Mitch-json/Smart-Toilet/Board Drawings/Right View.png

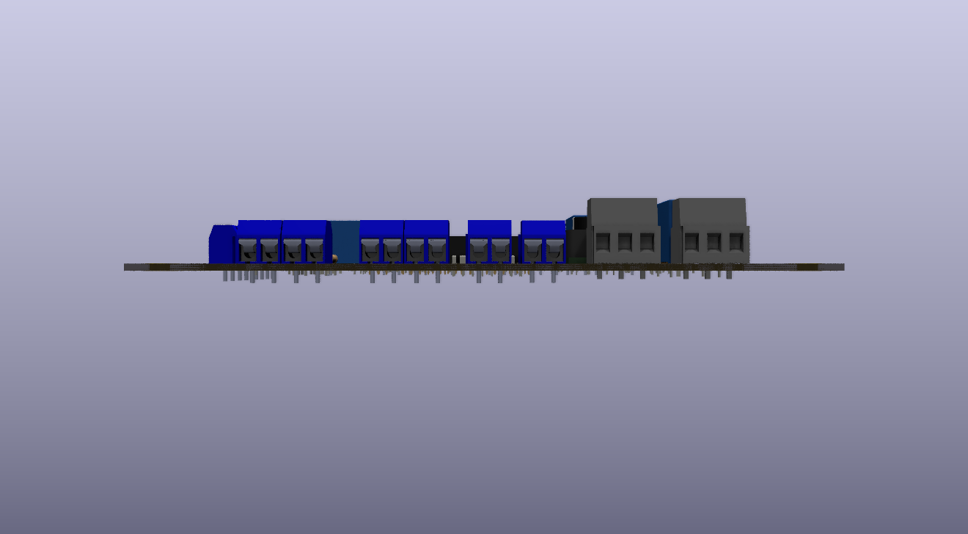
Board Drawings/Right View.png
