Mitch-json/Smart-Toilet/Board Drawings/Top View Animated.png

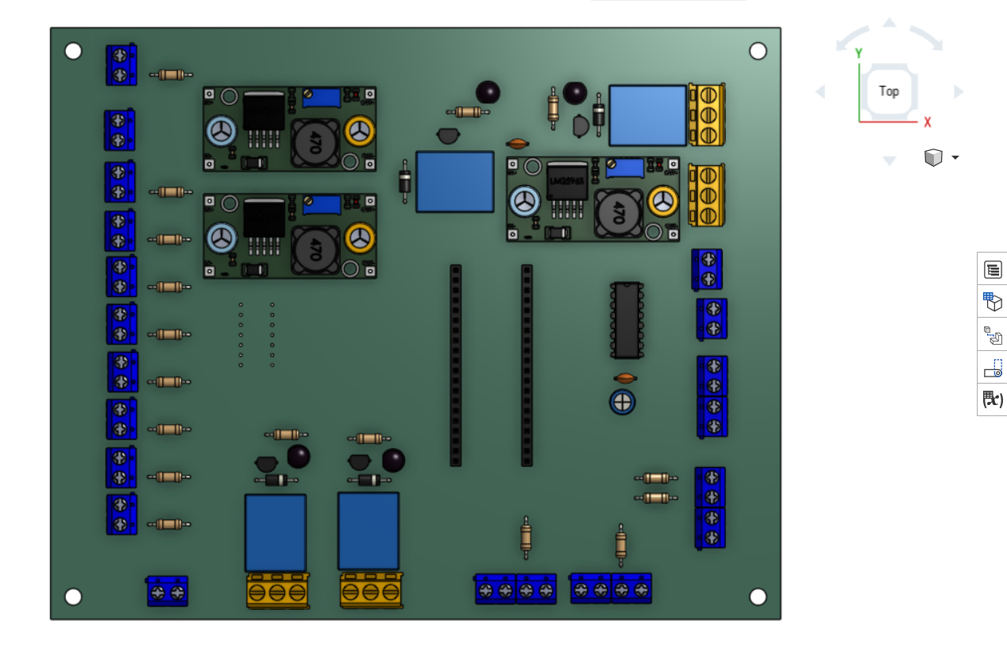
Board Drawings/Top View Animated.png
