Mitch-json/Smart-Toilet/3D Mechanical Designs/Motor Holder Dimensions.png

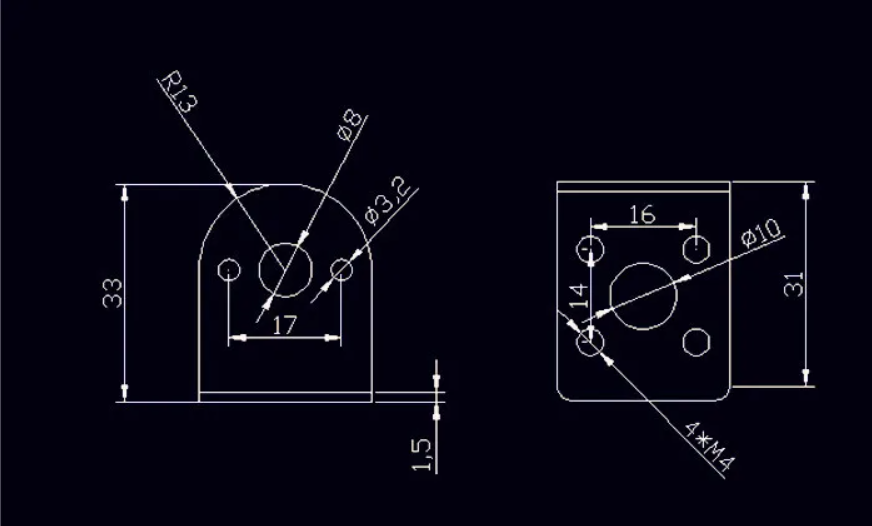
3D Mechanical Designs/Motor Holder Dimensions.png
