Mitch-json/Smart-Toilet/Board Drawings/Back View Animated.png

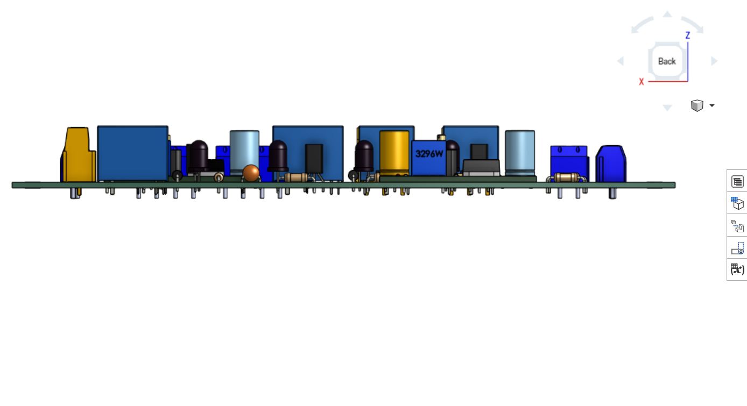
Board Drawings/Back View Animated.png
