Mitch-json/Smart-Toilet/Board Drawings/Back View Drawing.png

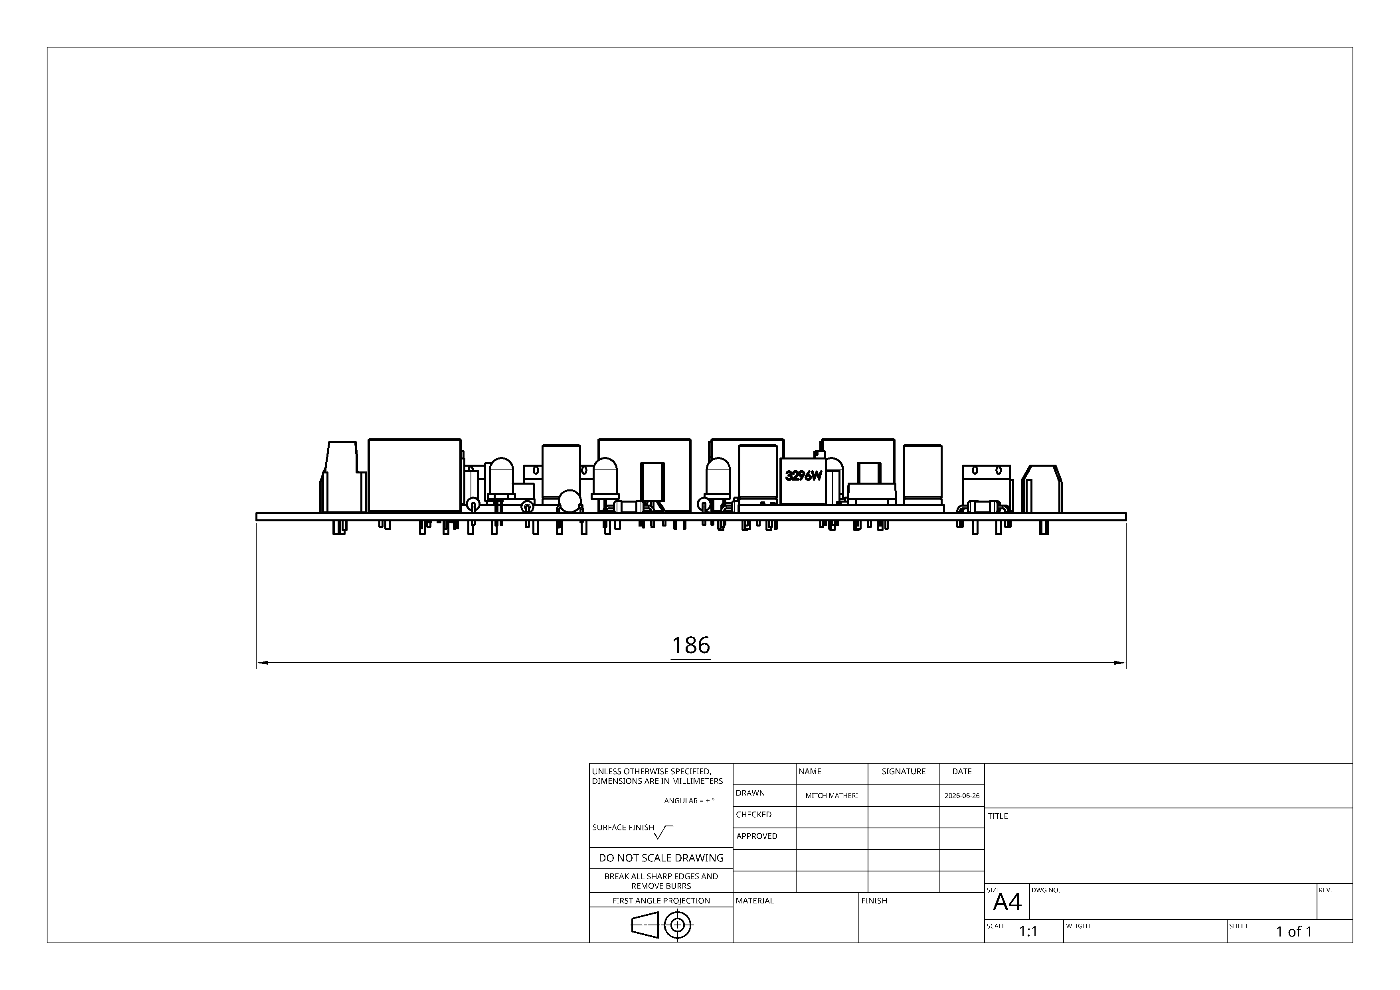
Board Drawings/Back View Drawing.png
