Mitch-json/Smart-Toilet/Board Drawings/Back View.png

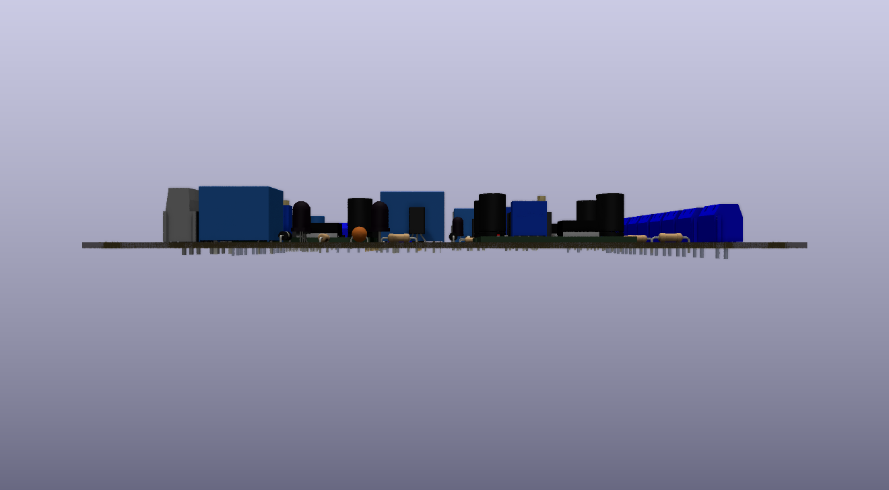
Board Drawings/Back View.png
