Mitch-json/Smart-Toilet/Board Drawings/Front View Animated.png

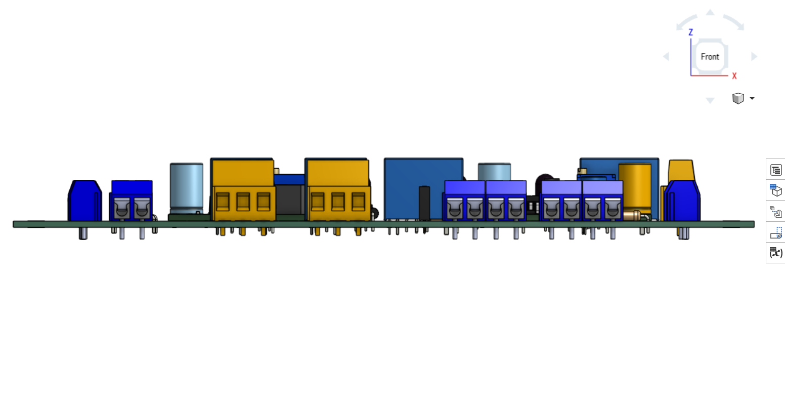
Board Drawings/Front View Animated.png
