Mitch-json/Smart-Toilet/Board Drawings/Front view Drawing.png

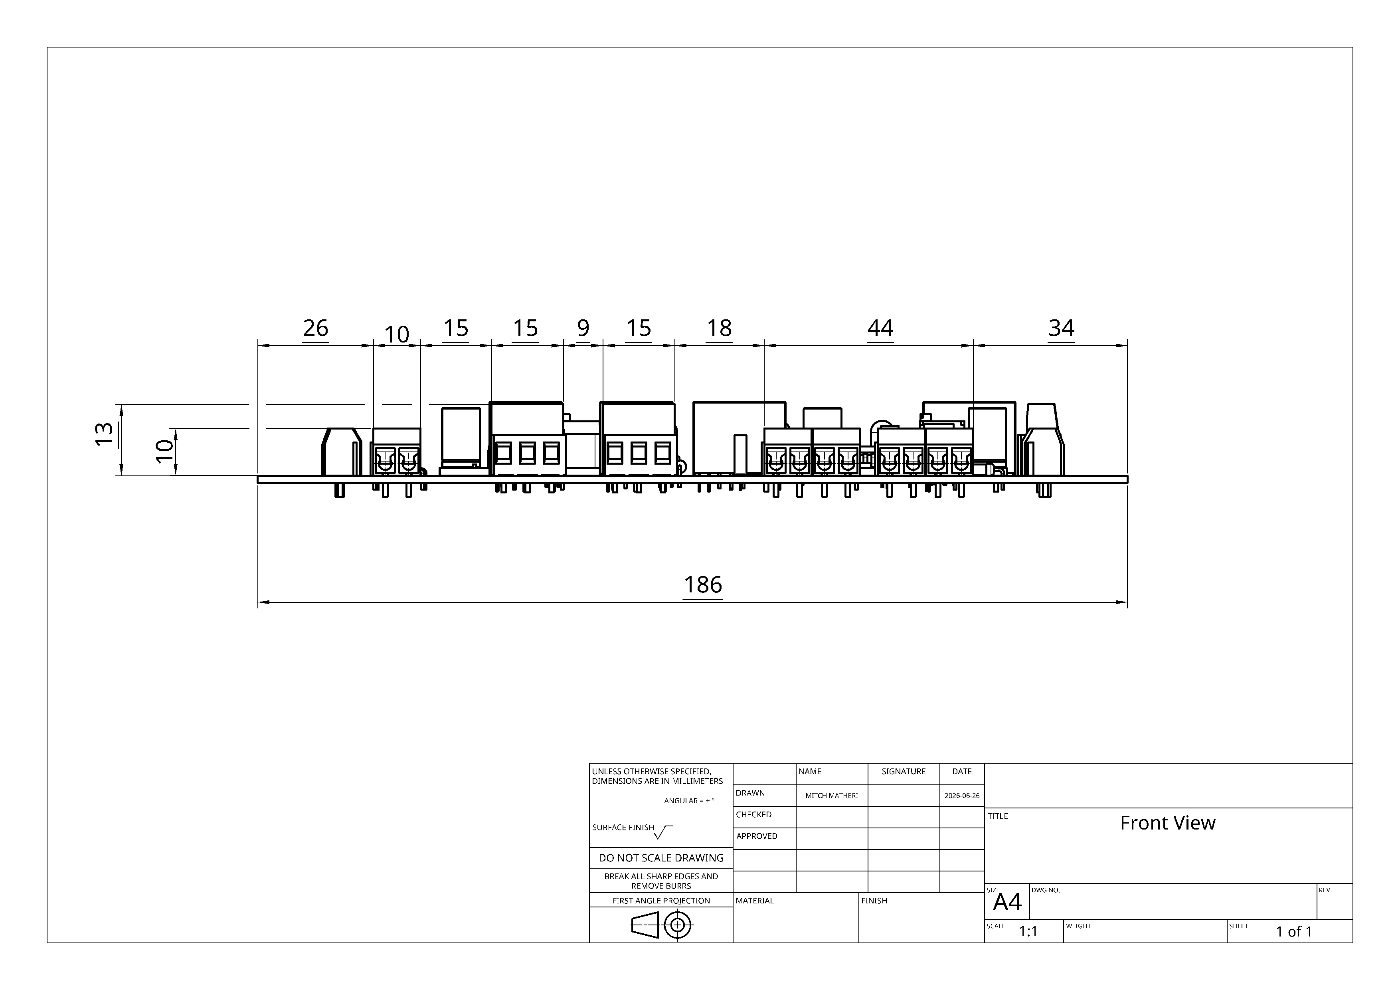
Board Drawings/Front view Drawing.png
