Mitch-json/Smart-Toilet/Board Drawings/Front View.png

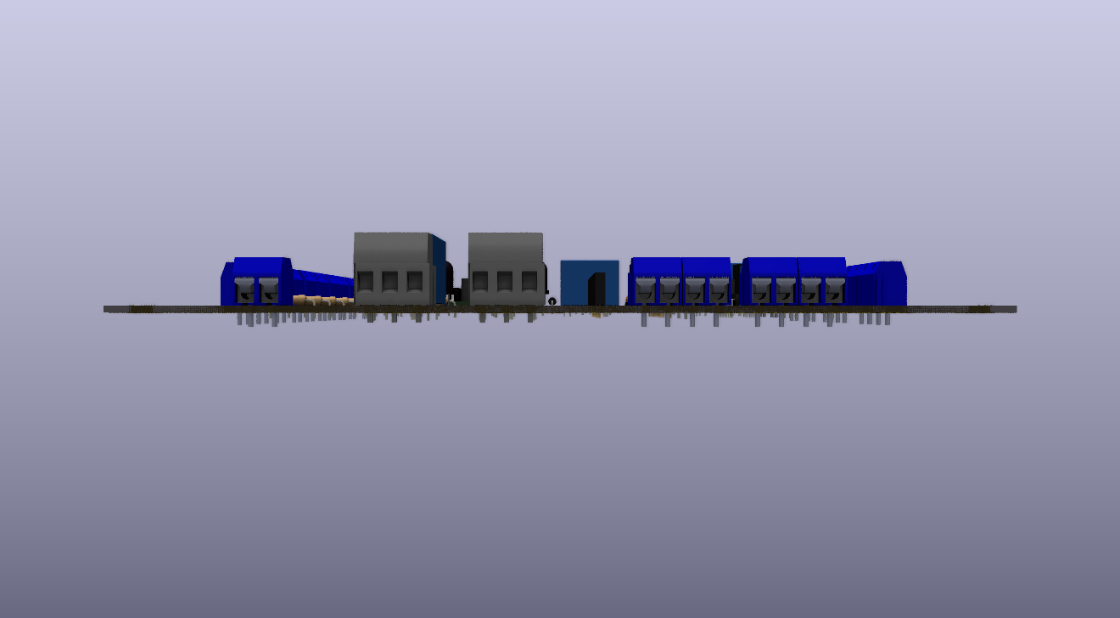
Board Drawings/Front View.png
