Mitch-json/Smart-Toilet/Board Drawings/Isometric view animated.png

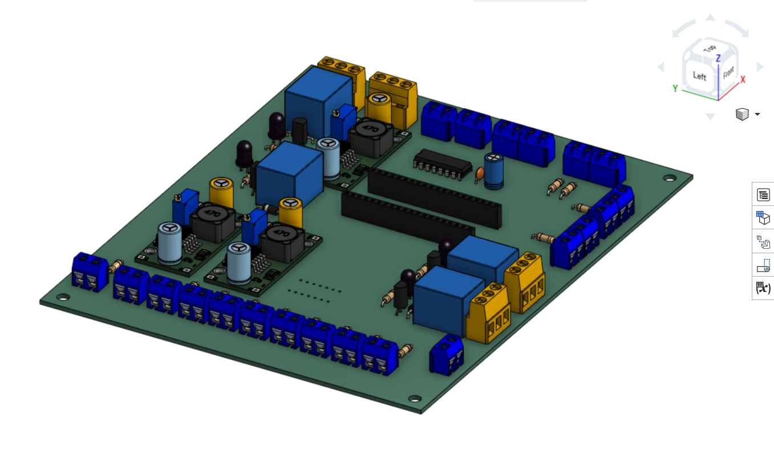
Board Drawings/Isometric view animated.png
