Mitch-json/Smart-Toilet/Board Drawings/Isometric View Drawing.png

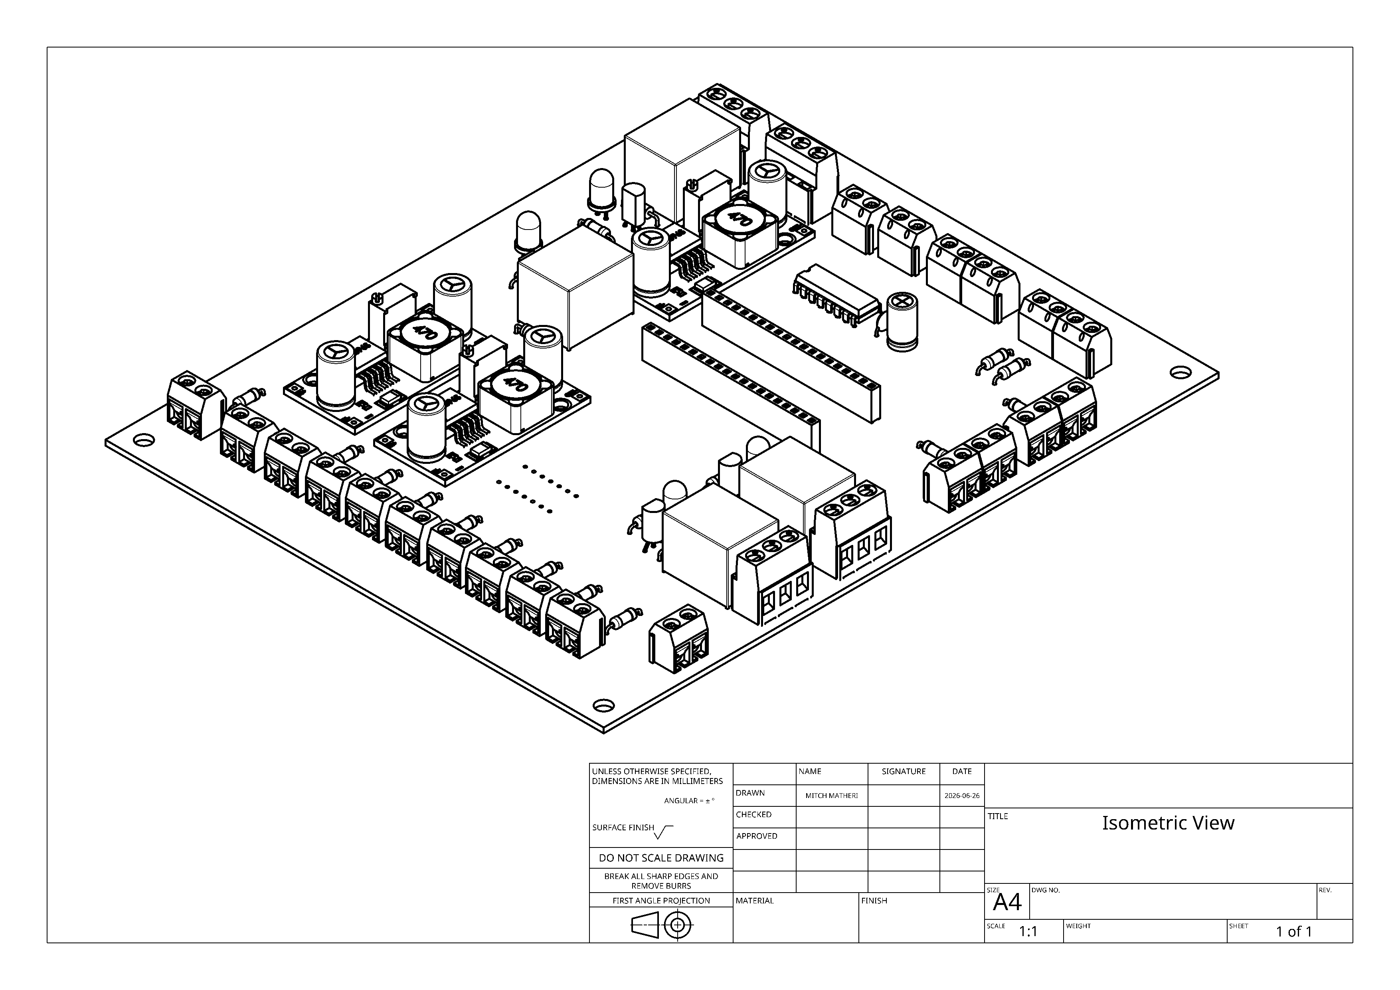
Board Drawings/Isometric View Drawing.png
