Mitch-json/Smart-Toilet/Board Drawings/Isometric View.png

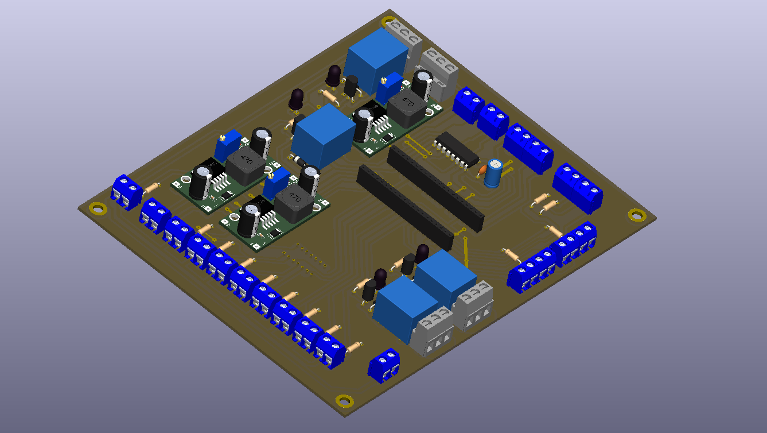
Board Drawings/Isometric View.png
