Mitch-json/Smart-Toilet/Board Drawings/Left View Animated.png

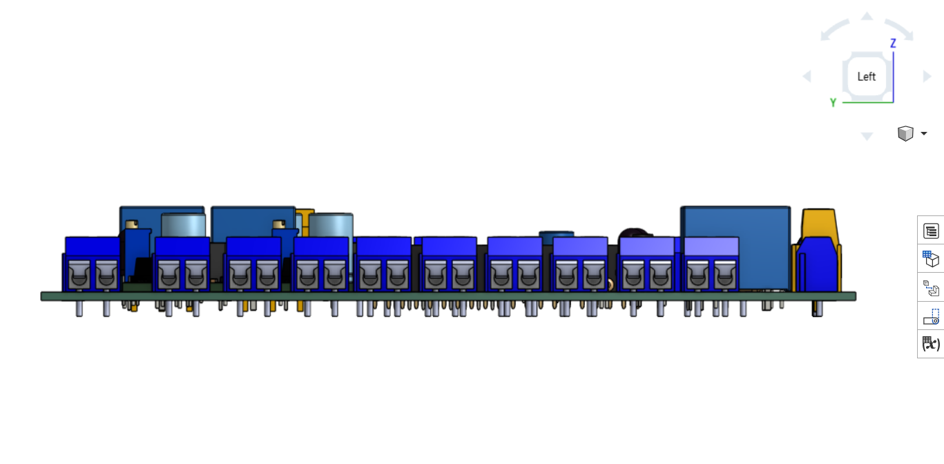
Board Drawings/Left View Animated.png
