Mitch-json/Smart-Toilet/Board Drawings/Left View Drawing.png

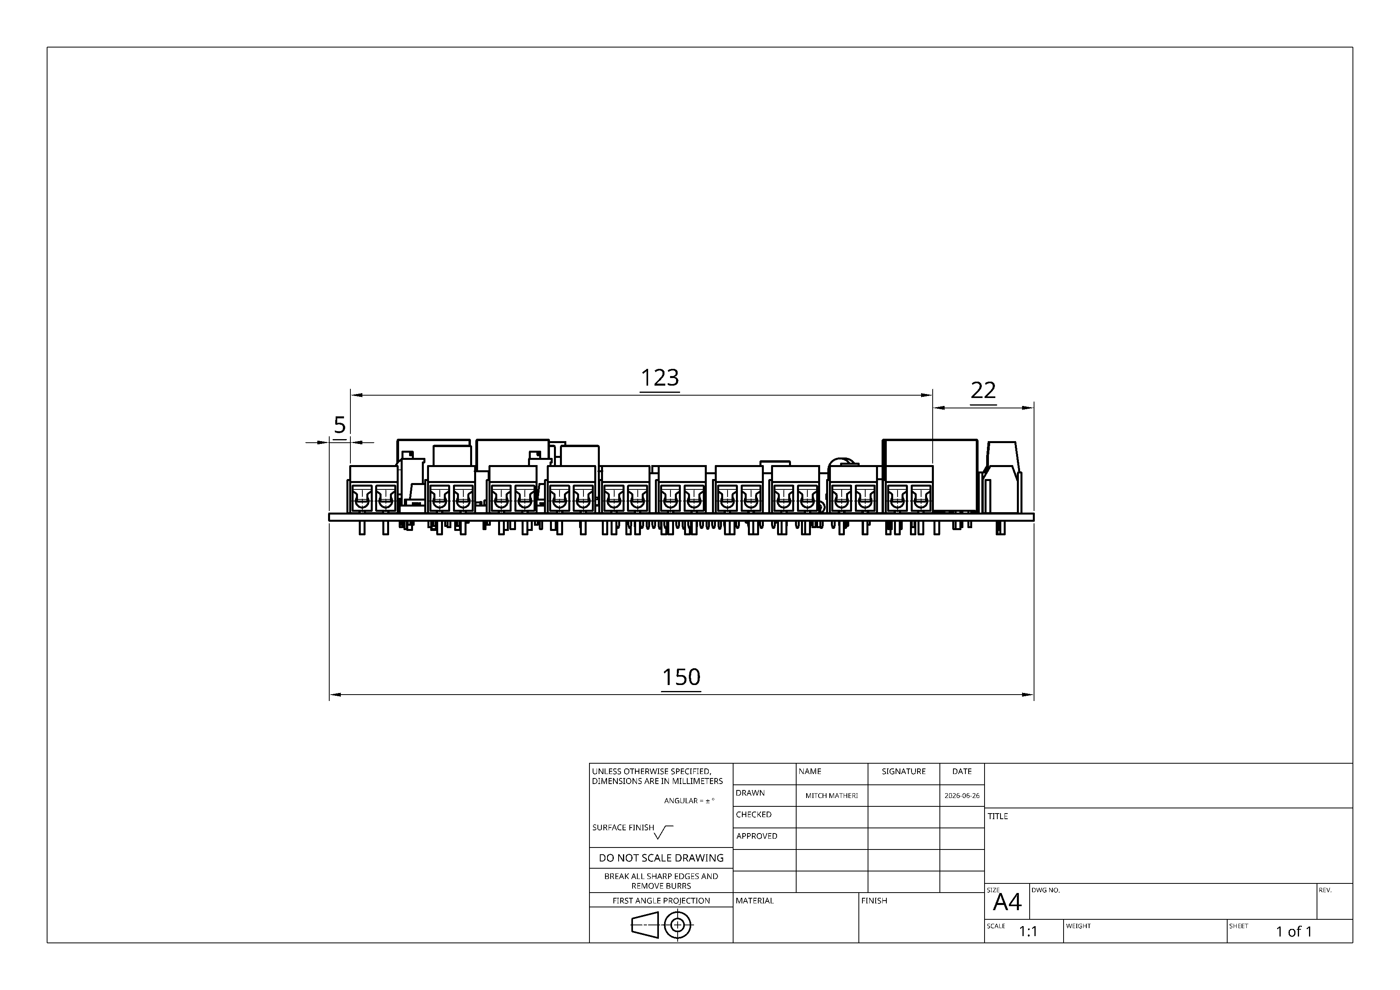
Board Drawings/Left View Drawing.png
