Mitch-json/Smart-Toilet/Board Drawings/Right View Animated.png

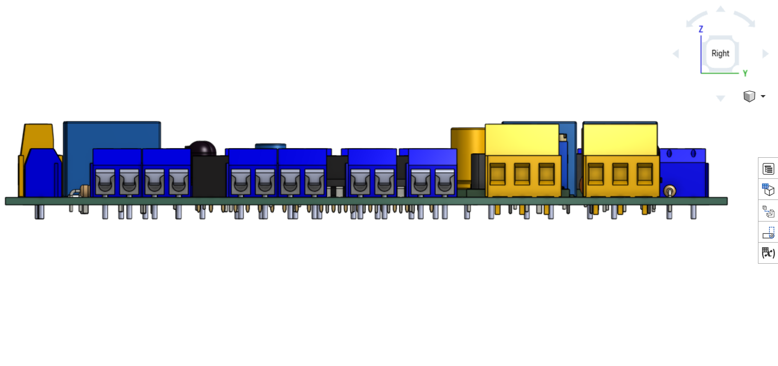
Board Drawings/Right View Animated.png
