Mitch-json/Smart-Toilet/Board Drawings/Right View Drawing.png

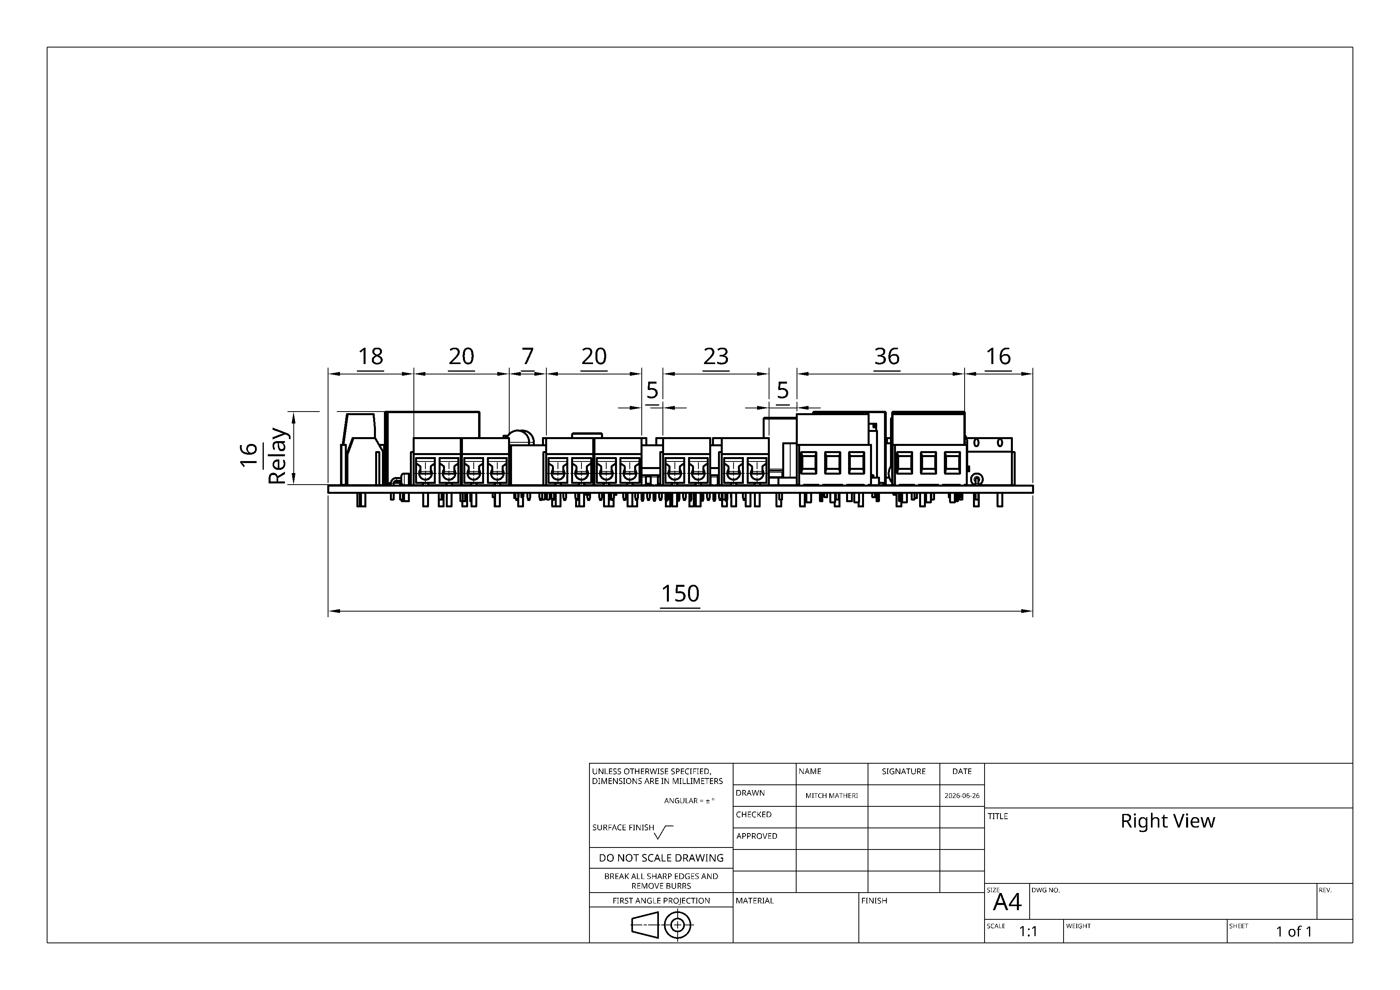
Board Drawings/Right View Drawing.png
