Mitch-json/Smart-Toilet/Board Drawings/Top View Drawing.png

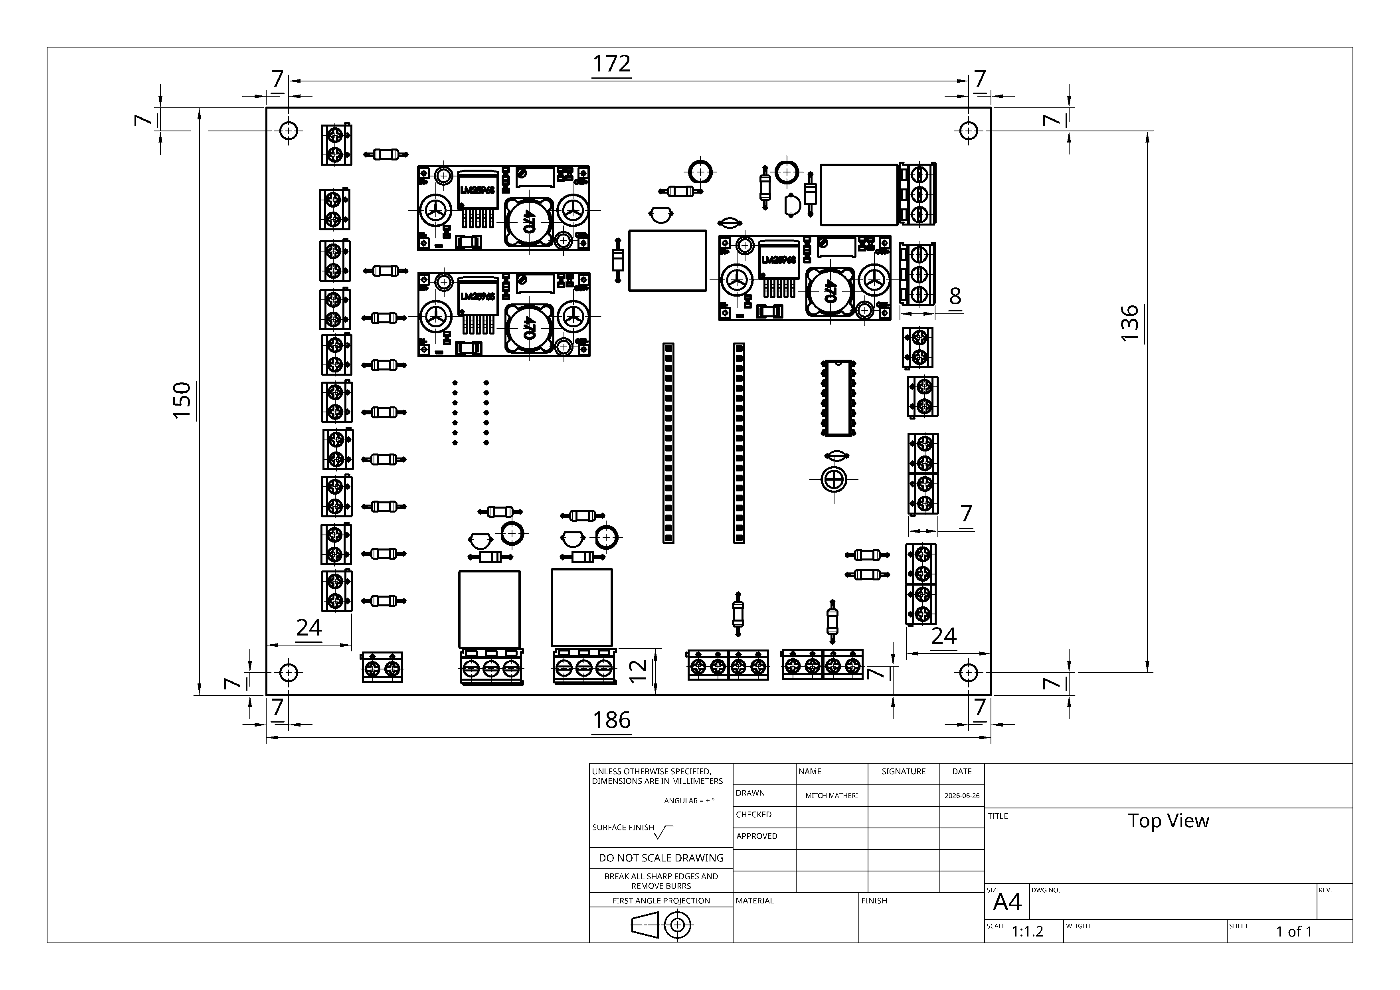
Board Drawings/Top View Drawing.png
