Mitch-json/Smart-Toilet/Board Drawings/Top View.png

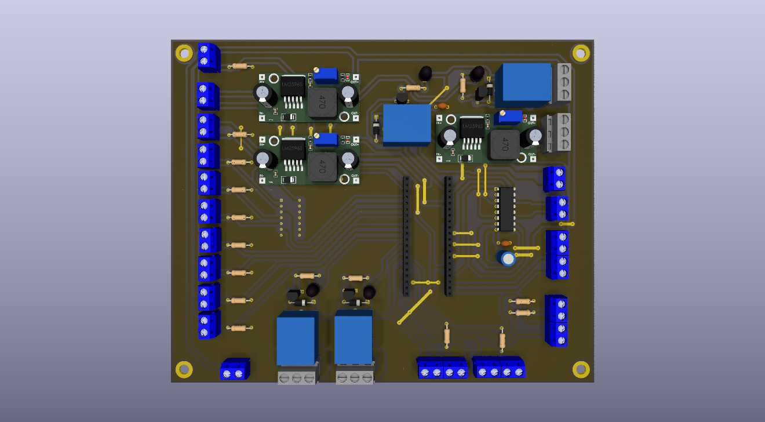
Board Drawings/Top View.png
