Mitch-json/Smart-Toilet/BOQ/BOM - Electronics.csv

Pixel Engineering - Nairobi
Product | SKU | QTY | Unit Price | Total Price
LM2596 DC-DC Buck Converter Step-down Power Module | PEDBC61 | 3 | 200 | 600
 | PEQWS71 | 1 | 40 | 40
16 pin DIP IC Socket | PESTS36E | 2 | 20 | 40
Diffused 3mm Red Led | PELED81R | 5 | 5 | 25
IN5817 Schottky Diode | PEDID51M | 5 | 20 | 100
Grand Total |  |  |  | 815
Sagana Electronics
Product | QTY | Unit Price | Total Price
5V SPDT Power Relay | 4 | 50 | 200
0.1uF | 2 | 10 | 20
Screw Terminal Block: 3-Pin, 5 mm Pitch (Blue) | 6 | 30 | 180
Screw Terminal Block: 2-Pin, 5 mm Pitch (Blue) | 19 | 15 | 285
2N222 NPN BJT Transistor | 4 | 5 | 20
330 Ohm Resistors | 5 | 5 | 25
2K Ohn Resistors | 4 | 5 | 20
1K Ohn Resistors | 11 | 5 | 55
Copper Clad Board Single Sided 15 x 20cm x 1.5mm | 1 | 200 | 200
47uF 16V Radial Electrolytic Capacitor | 1 | 5 | 200
Header Pin Female Round pin (Header connector) | 1 | 40 | 200
Grand Total |  |  | 1405
