Mitch-json/Smart-Toilet/3D Mechanical Designs/Assembly Drawing.step

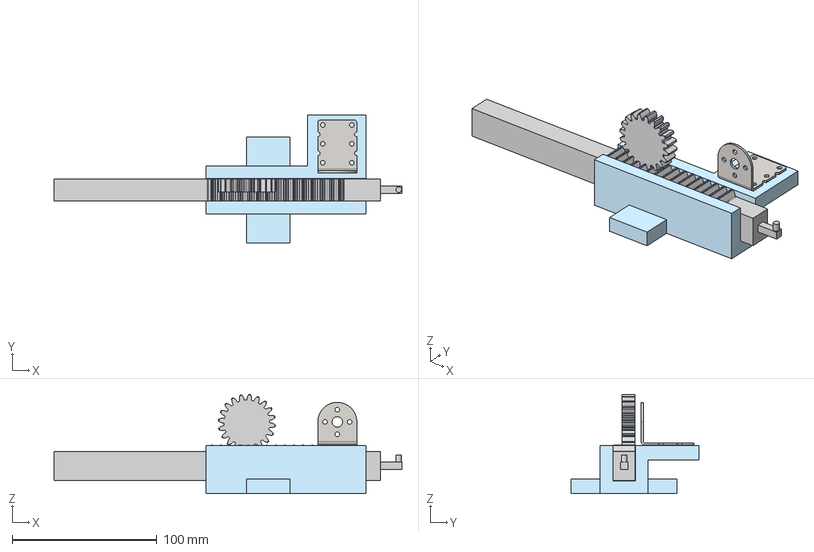
[picture p19: CAD file, 2026-07-27]
3D Mechanical Designs/Assembly Drawing.step
240.0 x 87.9 x 68.6 mm
Suporte_Motor_25mm
