Mitch-json/Smart-Toilet/3D Mechanical Designs/Suporte_Motor_25mm.STEP

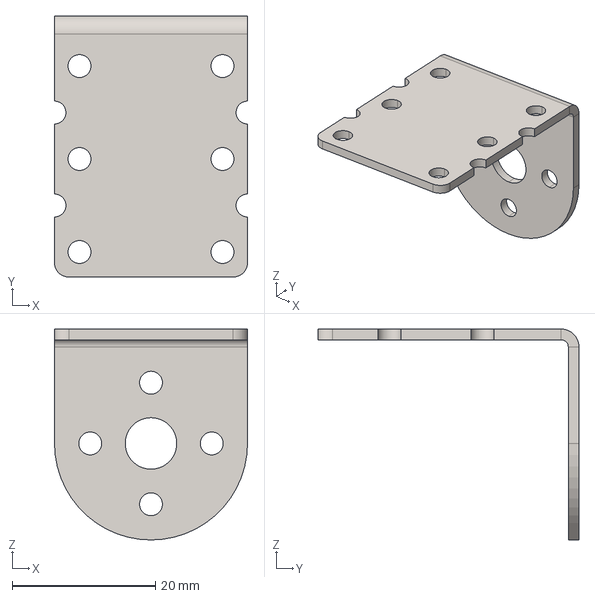
[picture p20: CAD file, 2026-07-27]
3D Mechanical Designs/Suporte_Motor_25mm.STEP
27.0 x 36.5 x 29.5 mm
