Mitch-json/Smart-Toilet/PCB Schematics/kicad_libs/HC-SR04/HC-SR04.step

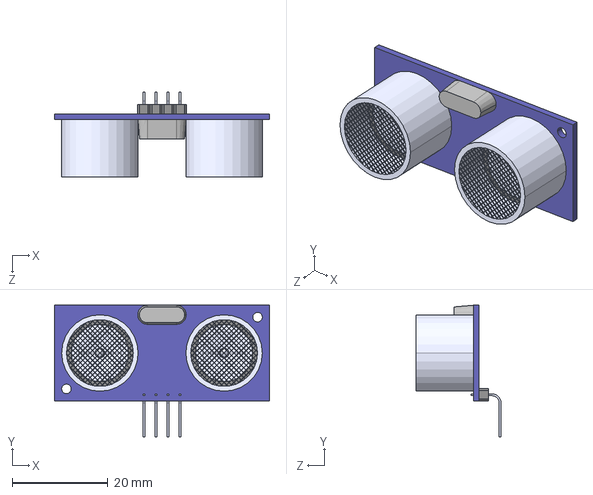
[picture p21: CAD file, 2026-06-28]
PCB Schematics/kicad_libs/HC-SR04/HC-SR04.step
45.0 x 27.5 x 17.8 mm
