Mitch-json/Smart-Toilet/PCB Schematics/kicad_libs/SN74HC32N/SN74HC32N.step

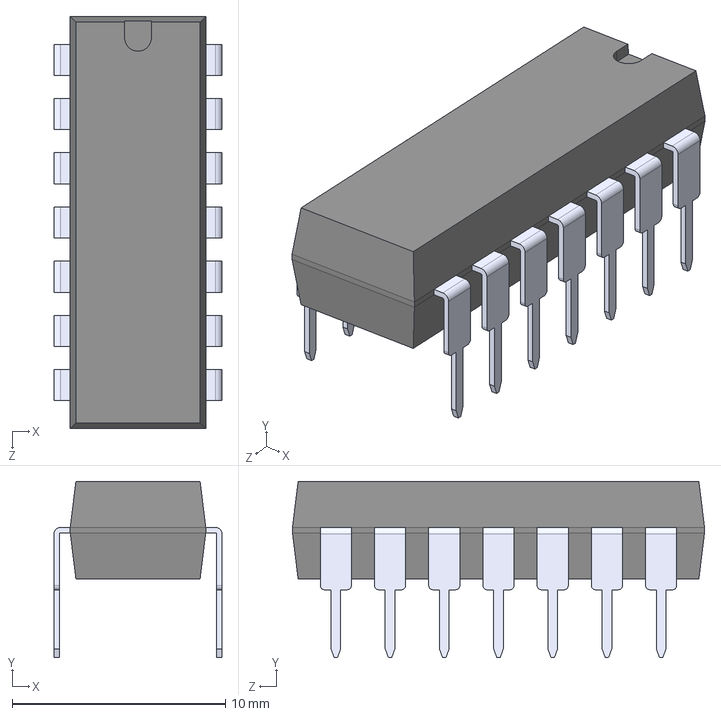
[picture p22: CAD file, 2026-06-28]
PCB Schematics/kicad_libs/SN74HC32N/SN74HC32N.step
7.87 x 8.26 x 19.3 mm
