Mitch-json/Smart-Toilet/3D Mechanical Designs/servo horn.step

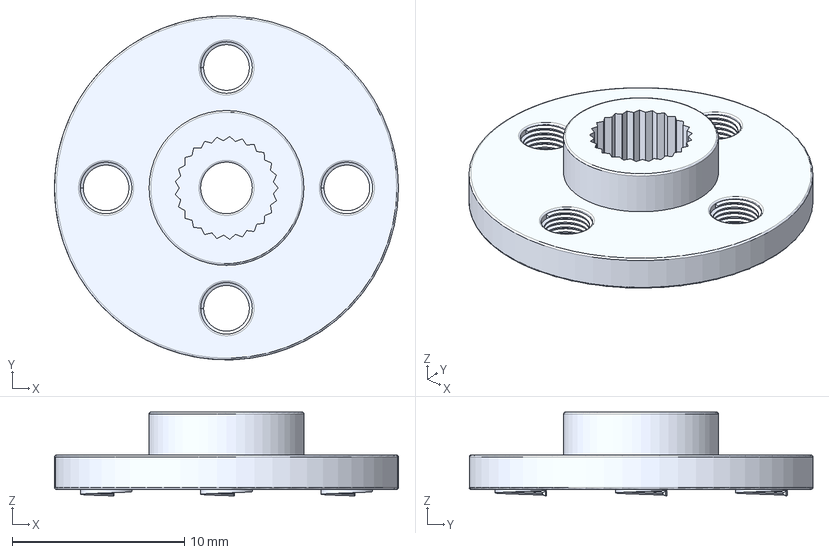
[picture p23: CAD file, 2026-07-27]
3D Mechanical Designs/servo horn.step
20.0 x 20.0 x 4.88 mm
