Mitch-json/Smart-Toilet/3D Mechanical Designs/Rack Gear Casing.step

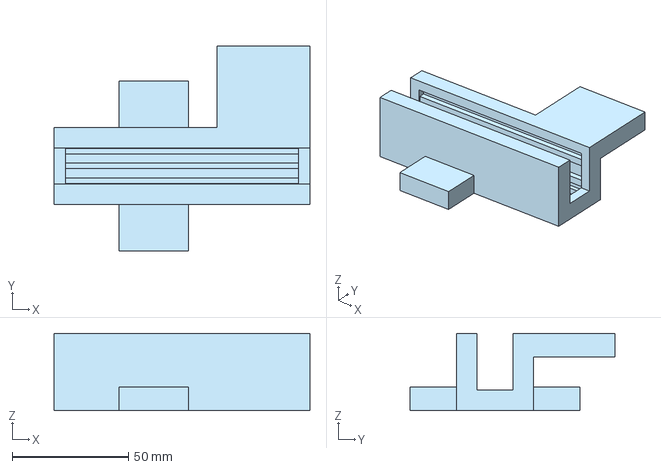
[picture p24: CAD file, 2026-07-27]
3D Mechanical Designs/Rack Gear Casing.step
110.0 x 87.9 x 33.1 mm
