Mitch-json/Smart-Toilet/3D Mechanical Designs/Rack Gear.step

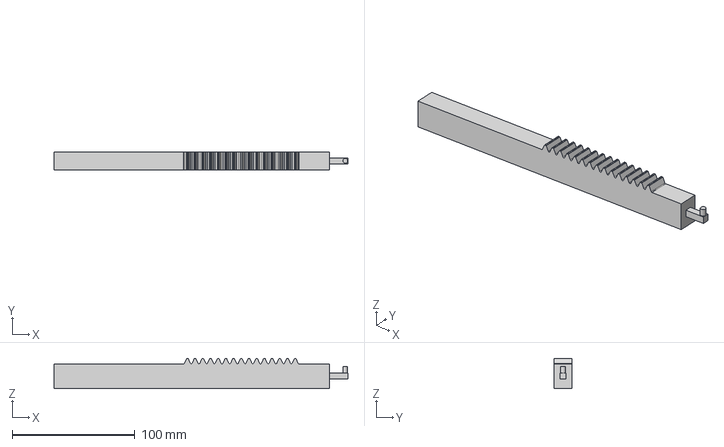
[picture p25: CAD file, 2026-07-27]
3D Mechanical Designs/Rack Gear.step
240.0 x 15.0 x 24.5 mm
