Mitch-json/Smart-Toilet/3D Mechanical Designs/Rack Gear Casing Front View.pdf

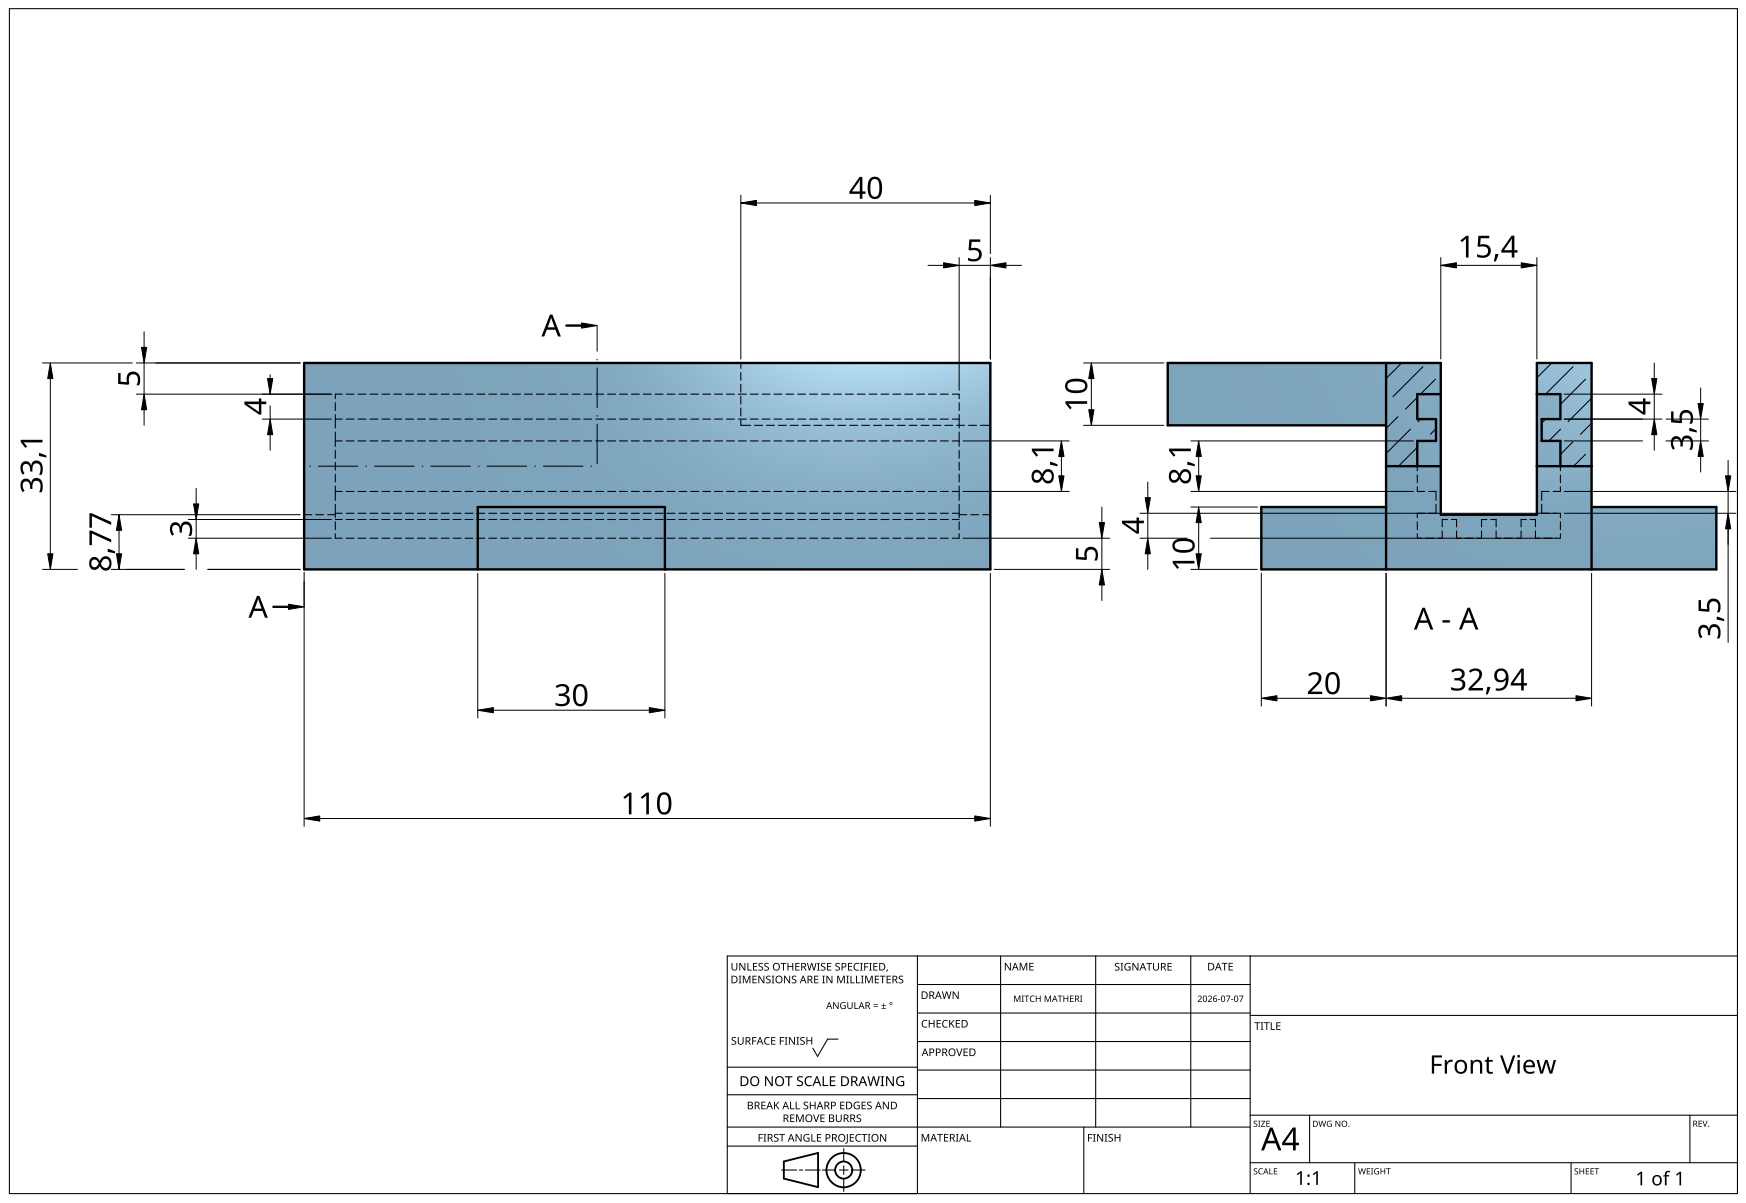
[picture p26: page 1]
