Mitch-json/Smart-Toilet/3D Mechanical Designs/Rack Gear Casing Right View.pdf

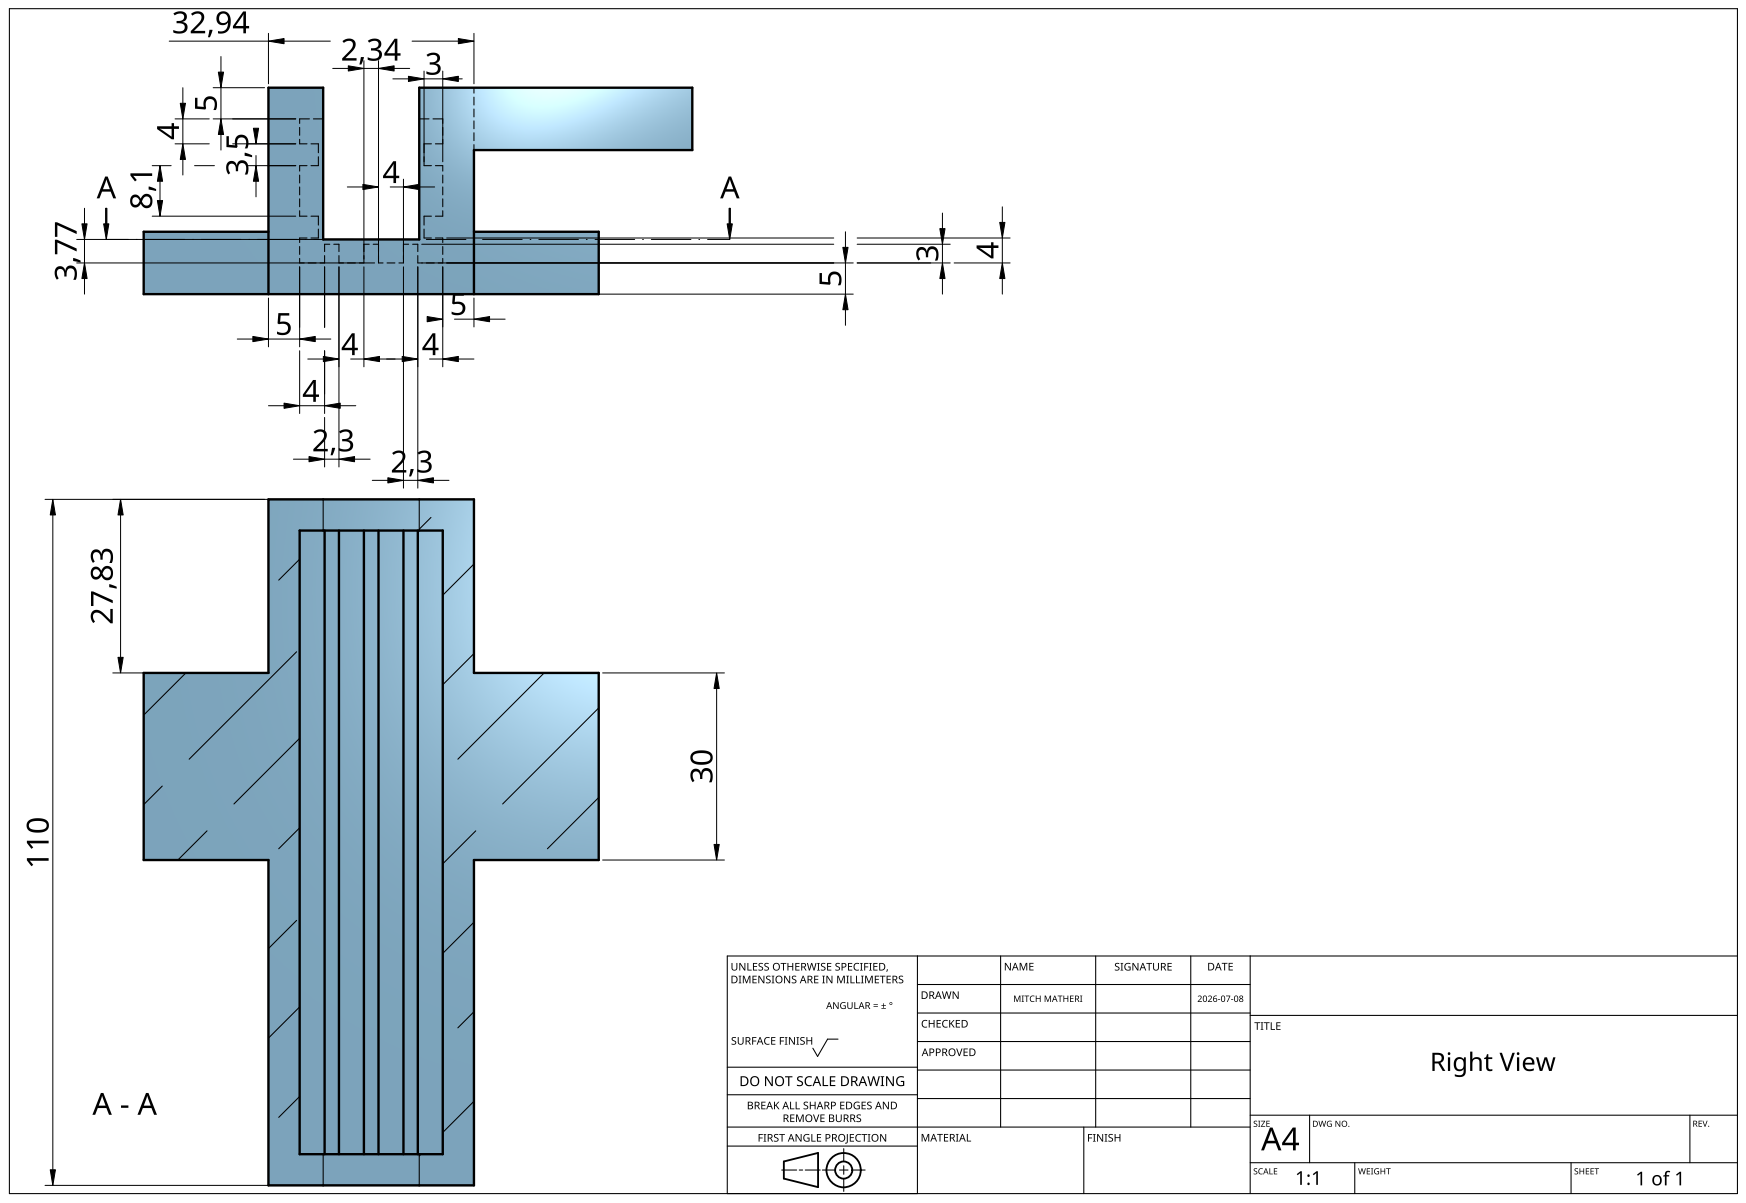
[picture p27: page 1]
