Mitch-json/Smart-Toilet/PCB Schematics/Smart Toilet.kicad_pcb

## KiCad design PCB Schematics/Smart Toilet.kicad_pcb (2026-08-11)

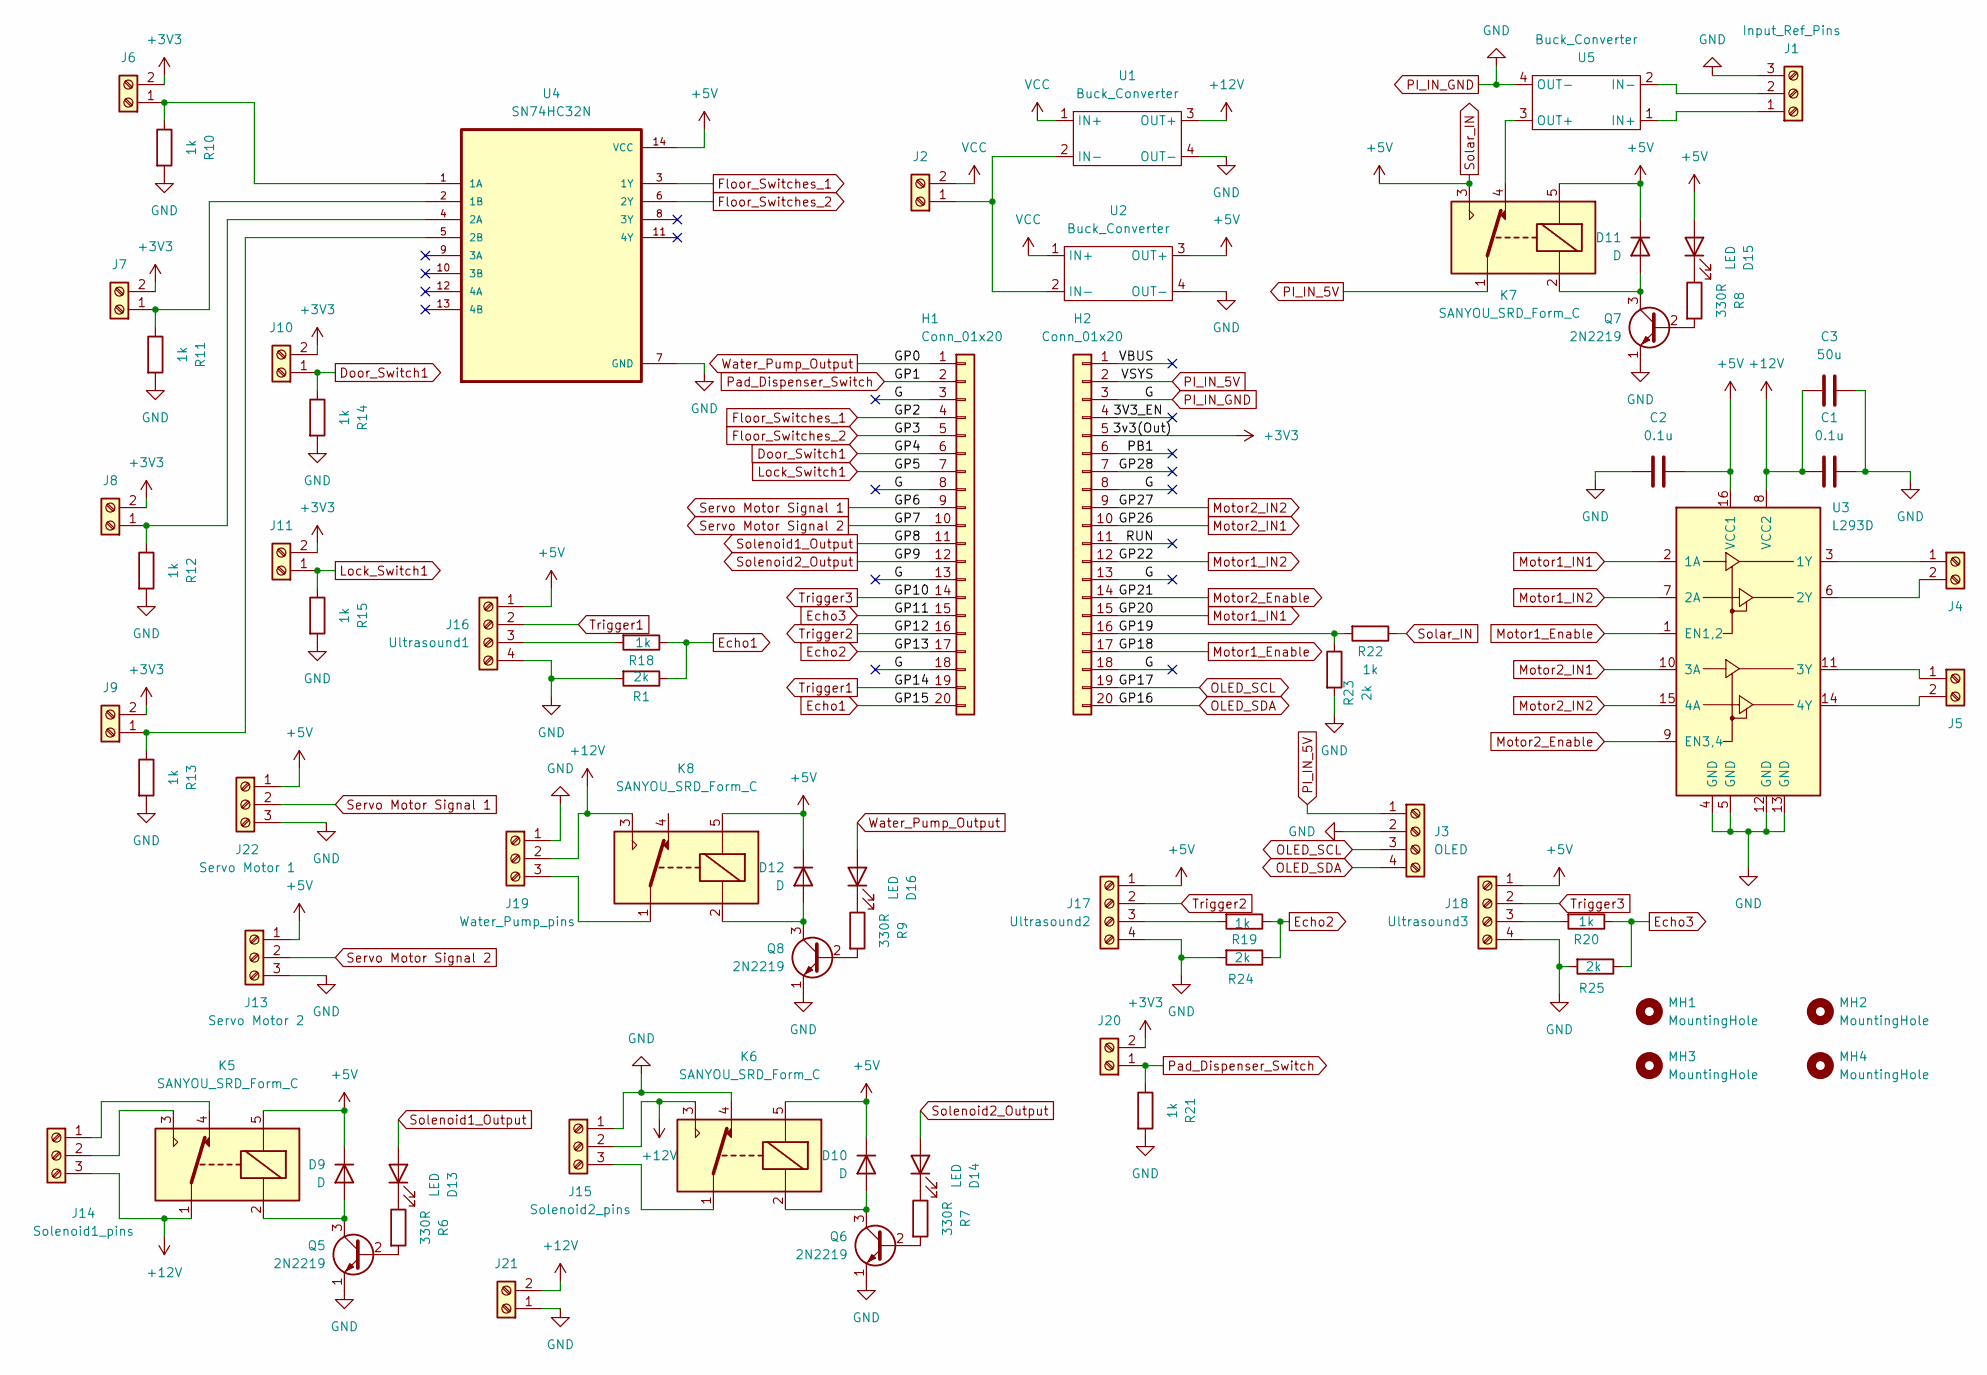
[picture p28: schematic Smart Toilet.kicad_sch]

Parts:
C1, C2: 0.1u; C_Disc_D4.7mm_W2.5mm_P5.00mm
C3: 50u; C_Radial_D6.3mm_H11.0mm_P2.50mm
D9, D10, D11, D12: D; D_A-405_P10.16mm_Horizontal
D13, D14, D15, D16: LED; LED_D5.0mm_IRBlack
H1, H2: Conn_01x20; PinSocket_1x20_P2.54mm_Vertical
J1: Input_Ref_Pins; TerminalBlock_MaiXu_MX126-5.0-03P_1x03_P5.00mm
J2, J6, J7, J8, J9, J10, J11, J20, J21: Screw_Terminal_01x02; TerminalBlock_MaiXu_MX126-5.0-02P_1x02_P5.00mm
J3: OLED; TerminalBlock_MaiXu_MX126-5.0-04P_1x04_P5.00mm
J4: Motor 1; TerminalBlock_MaiXu_MX126-5.0-02P_1x02_P5.00mm
J5: Motor 2; TerminalBlock_MaiXu_MX126-5.0-02P_1x02_P5.00mm
J13: Servo Motor 2; TerminalBlock_MaiXu_MX126-5.0-03P_1x03_P5.00mm
J14: Solenoid1_pins; TerminalBlock_MaiXu_MX126-5.0-03P_1x03_P5.00mm
J15: Solenoid2_pins; TerminalBlock_MaiXu_MX126-5.0-03P_1x03_P5.00mm
J16: Ultrasound1; TerminalBlock_MaiXu_MX126-5.0-04P_1x04_P5.00mm
J17: Ultrasound2; TerminalBlock_MaiXu_MX126-5.0-04P_1x04_P5.00mm
J18: Ultrasound3; TerminalBlock_MaiXu_MX126-5.0-04P_1x04_P5.00mm
J19: Water_Pump_pins; TerminalBlock_MaiXu_MX126-5.0-03P_1x03_P5.00mm
J22: Servo Motor 1; TerminalBlock_MaiXu_MX126-5.0-03P_1x03_P5.00mm
K5, K6, K7, K8: SANYOU_SRD_Form_C; Relay_SPDT_SANYOU_SRD_Series_Form_C
MH1, MH2, MH3, MH4: MountingHole; MountingHole_4.3mm_M4_DIN965_Pad
Q5, Q6, Q7, Q8: 2N2219; TO-92L_Inline_Wide
R1, R23, R24, R25: 2k; R_Axial_DIN0207_L6.3mm_D2.5mm_P10.16mm_Horizontal
R6, R7, R8, R9: 330R; R_Axial_DIN0207_L6.3mm_D2.5mm_P10.16mm_Horizontal
R10, R11, R12, R13, R14, R15, R18, R19, R20, R21, R22: 1k; R_Axial_DIN0207_L6.3mm_D2.5mm_P10.16mm_Horizontal
U1, U2, U5: Buck_Converter; Buck_converter
U3: L293D; DIP-16_W7.62mm
U4: SN74HC32N

Connections:
+3V3: H2.5, J6.2, J7.2, J8.2, J9.2, J10.2, J11.2, J20.2
+12V: C1.2, C3.2, J14.3, J15.2, J19.2, J21.2, K5.1, K6.3, K8.3, U1.3 (OUT+), U3.8 (VCC2)
/3V3_EN: H2.4
/GP19: H2.16, R22.2, R23.1
/GP28: H2.7
/PB1: H2.6
/RUN: H2.11
/VBUS: H2.1
Door_Switch1: H1.6, J10.1, R14.1
Echo1: H1.20, R1.1, R18.1
Echo2: H1.17, R19.1, R24.1
Echo3: H1.15, R20.1, R25.1
Floor_Switches_1: H1.4, U4.3 (1Y)
Floor_Switches_2: H1.5, U4.6 (2Y)
Lock_Switch1: H1.7, J11.1, R15.1
Motor1_Enable: H2.17, U3.1 (EN1,2)
Motor1_IN1: H2.15, U3.2 (1A)
Motor1_IN2: H2.12, U3.7 (2A)
Motor2_Enable: H2.14, U3.9 (EN3,4)
Motor2_IN1: H2.10, U3.10 (3A)
Motor2_IN2: H2.9, U3.15 (4A)
unnamed: D9.2 (A), K5.2, Q5.3 (C)
unnamed: D10.2 (A), K6.2, Q6.3 (C)
unnamed: D11.2 (A), K7.2, Q7.3 (C)
unnamed: D12.2 (A), K8.2, Q8.3 (C)
unnamed: D13.1 (K), R6.1
unnamed: D14.1 (K), R7.1
unnamed: D15.1 (K), R8.1
unnamed: D16.1 (K), R9.1
unnamed: J1.1, U5.1 (IN+)
unnamed: J1.2, U5.2 (IN-)
unnamed: J2.1, U1.2 (IN-), U2.2 (IN-)
unnamed: J4.1, U3.3 (1Y)
unnamed: J4.2, U3.6 (2Y)
unnamed: J5.1, U3.11 (3Y)
unnamed: J5.2, U3.14 (4Y)
unnamed: J6.1, R10.1, U4.1 (1A)
unnamed: J7.1, R11.1, U4.2 (1B)
unnamed: J8.1, R12.1, U4.4 (2A)
unnamed: J9.1, R13.1, U4.5 (2B)
unnamed: J14.1, K5.4
unnamed: J14.2, K5.3
unnamed: J15.3, K6.1
unnamed: J16.3, R18.2
unnamed: J17.3, R19.2
unnamed: J18.3, R20.2
unnamed: J19.3, K8.1
unnamed: Q5.2 (B), R6.2
unnamed: Q6.2 (B), R7.2
unnamed: Q7.2 (B), R8.2
unnamed: Q8.2 (B), R9.2
unnamed: K7.4, U5.3 (OUT+)
OLED_SCL: H2.19, J3.3
OLED_SDA: H2.20, J3.4
PI_IN_5V: H2.2, J3.1, K7.1
PI_IN_GND: C1.1, C2.2, C3.1, H1.3, H1.8, H1.13, H1.18, H2.3, H2.8, H2.13, H2.18, J1.3, J3.2, J13.3, J15.1, J16.4, J17.4, J18.4, J19.1, J21.1, J22.3, K6.4, Q5.1 (E), Q6.1 (E), Q7.1 (E), Q8.1 (E), R1.2, R10.2, R11.2, R12.2, R13.2, R14.2, R15.2, R21.2, R23.2, R24.2, R25.2, U1.4 (OUT-), U2.4 (OUT-), U3.4 (GND), U3.5 (GND), U3.12 (GND), U3.13 (GND), U4.7 (GND), U5.4 (OUT-)
Pad_Dispenser_Switch: H1.2, J20.1, R21.1
Servo Motor Signal 1: H1.9, J22.2
Servo Motor Signal 2: H1.10, J13.2
Solar_IN: C2.1, D9.1 (K), D10.1 (K), D11.1 (K), D12.1 (K), D15.2 (A), J13.1, J16.1, J17.1, J18.1, J22.1, K5.5, K6.5, K7.3, K7.5, K8.5, R22.1, U2.3 (OUT+), U3.16 (VCC1), U4.14 (VCC)
Solenoid1_Output: D13.2 (A), H1.11
Solenoid2_Output: D14.2 (A), H1.12
Trigger1: H1.19, J16.2
Trigger2: H1.16, J17.2
Trigger3: H1.14, J18.2
VCC: J2.2, U1.1 (IN+), U2.1 (IN+)
Water_Pump_Output: D16.2 (A), H1.1

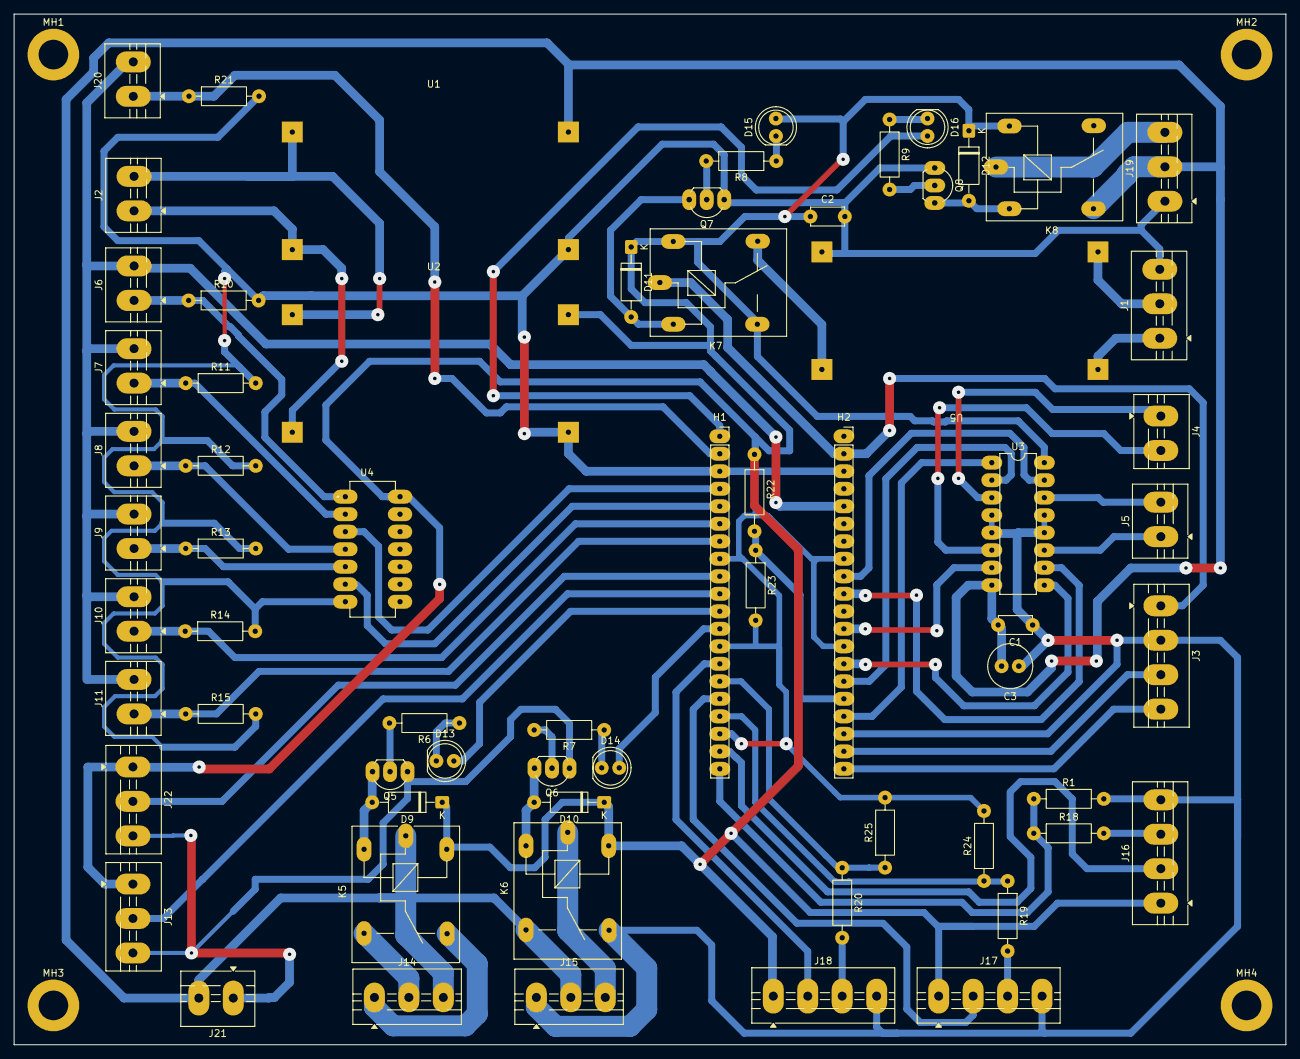
[picture p29: board Smart Toilet.kicad_pcb from above]

Board: 2 copper layers, 184.5 x 149.5 mm, 70 parts (0 on the bottom side), 62 nets.
