Mitch-json/Smart-Toilet/(commit log)

2026-06-28 Add Bulb Relay Logic
2026-06-29 Add Correct Bulb Relay Logic
    [main.py]
2026-07-27 Update PCB (Add Servo Motor Pins), Update Raspberry Pi Code
    [Assembly Drawing.step, Rack Gear Casing.step, Rack Gear.step, Smart Toilet.kicad_pcb, Smart Toilet.kicad_sch, Suporte_Motor_25mm.STEP, servo horn.step]
2026-08-10 PCB Route tracks Final Changes
    [Smart Toilet.kicad_pcb, Smart Toilet.kicad_sch]
2026-08-11 Improve System logs and add enoughWater status
    [Smart Toilet.kicad_pcb, Smart Toilet.kicad_sch]
2026-08-11 Add Floor Switch 2 logic, Add enoughWater Status, Add new email recipient
    [BOM - Electronics.csv]
